hkymstr/Telemetry-monitor/README.md

# Telemetry-monitor
telemetry monitor for raspberry pi pico
