hkymstr/Telemetry-monitor/CAN ADC/simulations/thermocouple_buffer.asc

R1: res; 169
R2: res; 10k
R3: res; 100
U1: OP07
V1: voltage; -5
V2: voltage; PULSE(0 50mV 0.1 10 .1 .1 20 1)
V3: voltage; 5
Named nets: 0, Vee, Vdd
Processor: ATMEL MEGA32U4-MU
$5 each
K type thermocouple
Output voltage: 0 (0C) to 50mV (1200C)
 
50mV to 3V => 60 gain
Gain = 60
A = 1 + R2/R1 = 1 +10k/169 => 60.2
.tran 20
