hkymstr/Telemetry-monitor/CAN ADC/simulations/power_regulator.asc

C1: cap; 2.2µF
C2: cap; 0.1µF
C3: cap; 12µF
C4: cap; 1µF
C5: cap; 4.7µF
C6: cap; 1µF
C7: cap; 22µF
C8: cap; 220pF
D1: diode; 1N4148
D2: schottky; 1N5818
D3: schottky; 1N5818
I1: current; PULSE(0 .1 .01 .00001 .00001 .02)
I2: current; PULSE(0 -.1 .01 .00001 .00001 .02)
L1: ind; 22µH
L2: ind; 10µH
L3: ind; 10µH
R1: res; 1k
R2: res; 1k
R3: res; 10k
R4: res; 10k
R5: res; 30k
R6: res; 1k
R7: res; 29.4k
R8: res; 1k
R9: res; 1k
U1: LT1121-3.3
U2: LT1933
U3: LT1931A
V4: voltage; PULSE(14 8 .01 .00001 .000001 .02 1)
Named nets: 0
.tran 1
R5 = R4*(Vout/1.245-1)
R7 = (|Vout|-1.255)/((1.255/R3)+(8*10^-6))
