hkymstr/Telemetry-monitor/CAN ADC/CAN_adc/CAN_adc.kicad_pcb

## KiCad design CAN ADC/CAN_adc/CAN_adc.kicad_pcb (2024-12-15)

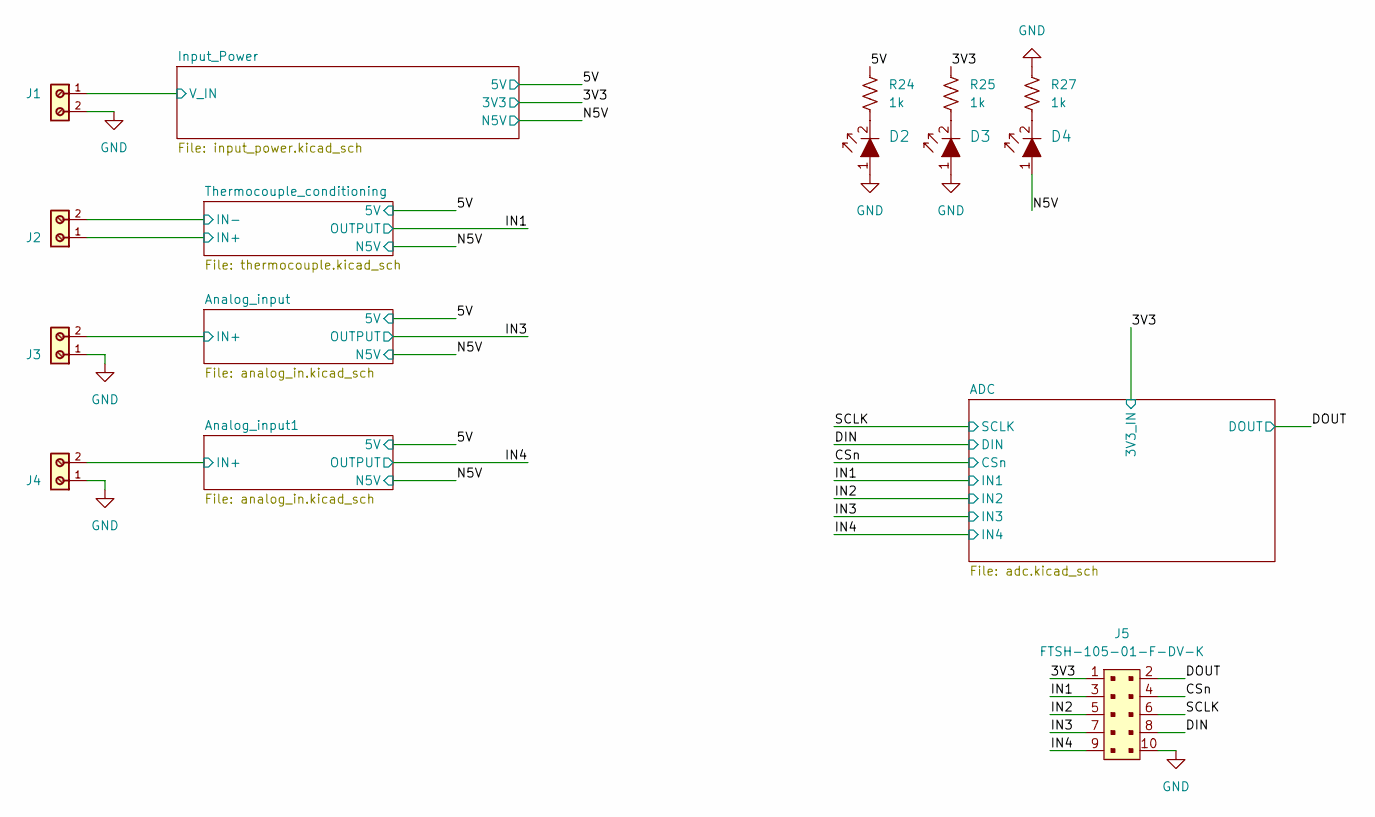
[picture p1: schematic CAN_adc.kicad_sch]

Parts:
D2, D3, D4: LG_L29K-G2J1-24-Z; 0603; MPN LG L29K-G2J1-24-Z; Digi-Key_PN 475-2709-1-ND
J1, J2, J3, J4: 691137710002; PART-NUMBER 691137710002
J5: FTSH-105-01-F-DV-K; PinHeader_2x5_P1.27_SMD; MPN FTSH-105-01-F-DV-K; Digi-Key_PN SAM8796-ND
R24, R25, R27: 1k; R_0603_1608Metric

Connections:
/3V3: J5.1, R25.1; also elsewhere on the board
/5V: R24.1; also elsewhere on the board
/Analog_input1/IN+: J4.2; also elsewhere on the board
/Analog_input/IN+: J3.2; also elsewhere on the board
/CSn: J5.4; also elsewhere on the board
/DIN: J5.8; also elsewhere on the board
/DOUT: J5.2; also elsewhere on the board
/IN1: J5.3; also elsewhere on the board
/IN2: J5.5; also elsewhere on the board
/IN3: J5.7; also elsewhere on the board
/IN4: J5.9; also elsewhere on the board
/Input_Power/V_IN: J1.1; also elsewhere on the board
/N5V: D4.1; also elsewhere on the board
/SCLK: J5.6; also elsewhere on the board
/Thermocouple_conditioning/IN+: J2.1; also elsewhere on the board
/Thermocouple_conditioning/IN-: J2.2; also elsewhere on the board
GND: D2.1, D3.1, J1.2, J3.1, J4.1, J5.10, R27.1; also elsewhere on the board
unnamed: D2.2, R24.2
unnamed: D3.2, R25.2
unnamed: D4.2, R27.2

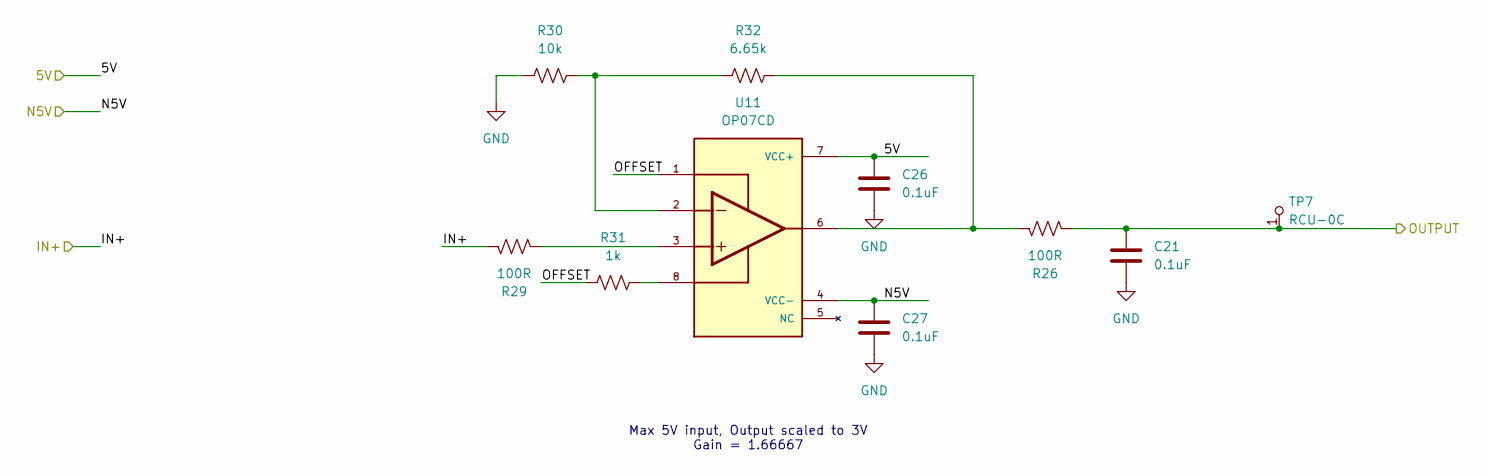
[picture p2: schematic analog_in.kicad_sch]

Parts:
C21, C26, C27: 0.1uF; C_0603_1608Metric_Pad1.08x0.95mm_HandSolder; Part Number CL10B104KB8NNNC
R26, R29: 100R; R_0603_1608Metric; Part Number RC0603FR-07100RL
R30: 10k; R_0603_1608Metric; Part Number RC0603FR-0710KL
R31: 1k; R_0603_1608Metric
R32: 6.65k; R_0603_1608Metric; Part Number RC0603FR-076K65L
TP7: RCU-0C; PROBE_PAD_0603; MPN RCU-0C; Digi-Key_PN A106145CT-ND
U11: OP07CD; SOIC127P599X175-8N

Connections:
/5V: C26.1, U11.7 (VCC+); also elsewhere on the board
/Analog_input/IN+: R29.1; also elsewhere on the board
/Analog_input/OFFSET: R31.1, U11.1
/IN3: C21.1, R26.2, TP7.1; also elsewhere on the board
/N5V: C27.1, U11.4 (VCC-); also elsewhere on the board
GND: C21.2, C26.2, C27.2, R30.1; also elsewhere on the board
unnamed: R26.1, R32.2, U11.6
unnamed: R29.2, U11.3
unnamed: R30.2, R32.1, U11.2
unnamed: R31.2, U11.8

Parts of its further copies:
C16, C17, C18: 0.1uF; C_0603_1608Metric_Pad1.08x0.95mm_HandSolder; Part Number CL10B104KB8NNNC
R19, R23: 100R; R_0603_1608Metric; Part Number RC0603FR-07100RL
R20: 10k; R_0603_1608Metric; Part Number RC0603FR-0710KL
R21: 1k; R_0603_1608Metric
R22: 6.65k; R_0603_1608Metric; Part Number RC0603FR-076K65L
TP6: RCU-0C; PROBE_PAD_0603; MPN RCU-0C; Digi-Key_PN A106145CT-ND
U7: OP07CD; SOIC127P599X175-8N

Connections of its further copies:
/5V: C16.1, U7.7 (VCC+); also elsewhere on the board
/Analog_input1/IN+: R19.1; also elsewhere on the board
/Analog_input1/OFFSET: R21.1, U7.1
/IN4: C18.1, R23.2, TP6.1; also elsewhere on the board
/N5V: C17.1, U7.4 (VCC-); also elsewhere on the board
GND: C16.2, C17.2, C18.2, R20.1; also elsewhere on the board
unnamed: R19.2, U7.3
unnamed: R20.2, R22.1, U7.2
unnamed: R21.2, U7.8
unnamed: R22.2, R23.1, U7.6

Notes on the sheet:
Max 5V input, Output scaled to 3V Gain = 1.66667

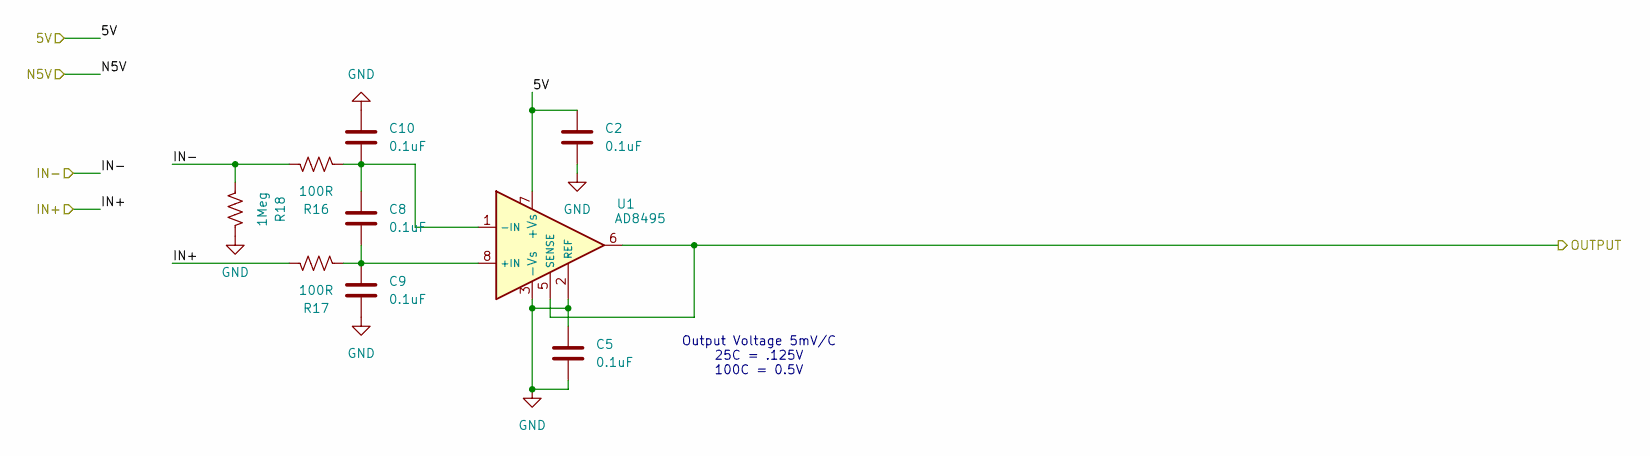
[picture p3: schematic thermocouple.kicad_sch]

Parts:
C2, C5, C8, C9, C10: 0.1uF; C_0603_1608Metric_Pad1.08x0.95mm_HandSolder; Part Number CL10B104KB8NNNC
R16, R17: 100R; R_0603_1608Metric; Part Number RC0603FR-07100RL
R18: 1Meg; R_0603_1608Metric; Part Number RC0603FR-071ML
U1: AD8495; MSOP-8_3x3mm_P0.65mm

Connections:
/5V: C2.1, U1.7 (+Vs); also elsewhere on the board
/IN1: U1.5 (SENSE), U1.6; also elsewhere on the board
/Thermocouple_conditioning/IN+: R17.1; also elsewhere on the board
/Thermocouple_conditioning/IN-: R16.1, R18.2; also elsewhere on the board
GND: C2.2, C5.1, C5.2, C9.2, C10.1, R18.1, U1.2 (REF), U1.3 (-Vs); also elsewhere on the board
unnamed: C8.2, C9.1, R17.2, U1.8 (+IN)
unnamed: C8.1, C10.2, R16.2, U1.1 (-IN)

Notes on the sheet:
Output Voltage 5mV/C 25C = .125V 100C = 0.5V

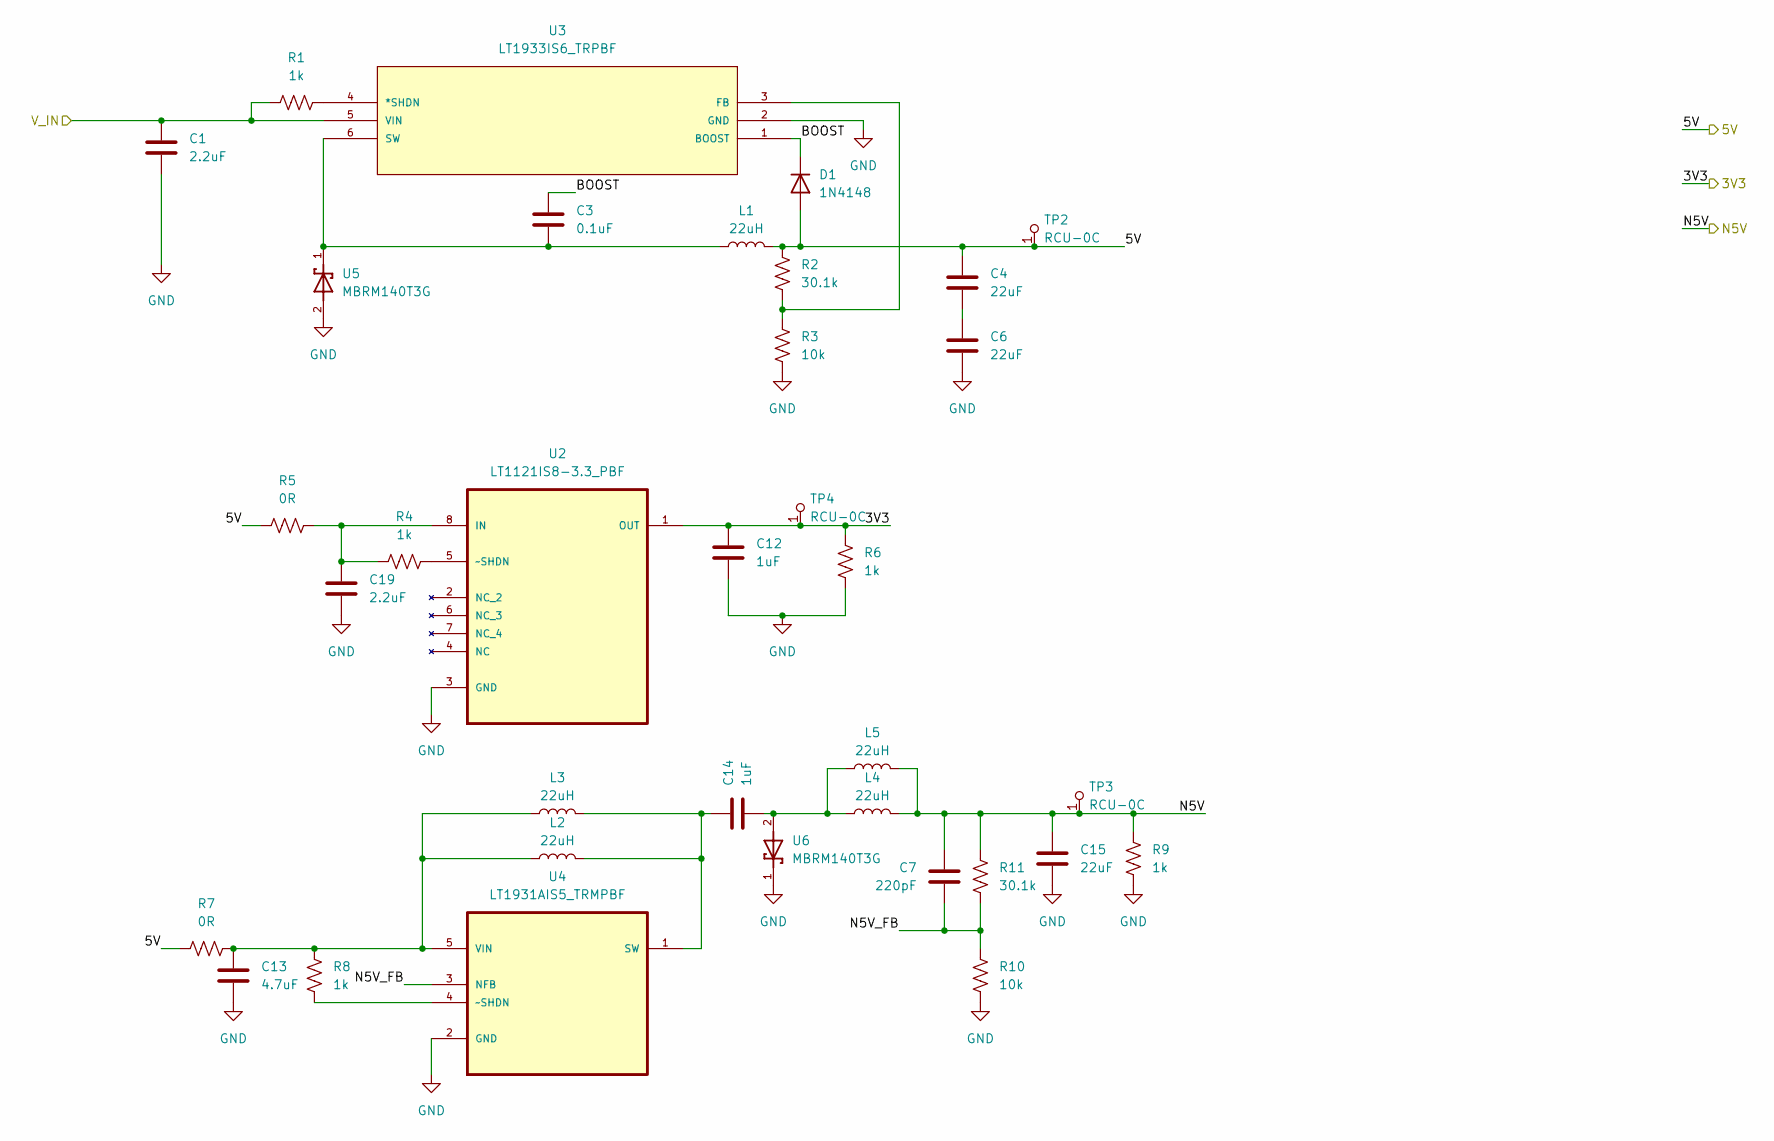
[picture p4: schematic input_power.kicad_sch]

Parts:
C1, C19: 2.2uF; C_1206_3216Metric; Part Number CL31B225KBHNNNE
C3: 0.1uF; C_0603_1608Metric_Pad1.08x0.95mm_HandSolder; Part Number CL10B104KB8NNNC
C4, C6, C15: 22uF; C_0805_2012Metric_Pad1.18x1.45mm_HandSolder; Part Number CL21A226MAYNNNE
C7: 220pF; C_0603_1608Metric_Pad1.08x0.95mm_HandSolder; Part Number 0603B221K500CT
C12, C14: 1uF; C_0603_1608Metric_Pad1.08x0.95mm_HandSolder; Part Number CL10B105KA8NNNC
C13: 4.7uF; C_1206_3216Metric_Pad1.33x1.80mm_HandSolder; Part Number CL31B475KBHNFNE
D1: 1N4148; D_SOD-523; Part Number 1N4148WT
L1, L2, L3, L4, L5: 22uH; L_1210_3225Metric_Pad1.42x2.65mm_HandSolder; Part Number CBC3225T220KR
R1, R4, R6, R8, R9: 1k; R_0603_1608Metric
R2, R11: 30.1k; R_0603_1608Metric; Part Number RMCF0603FT30K1
R3, R10: 10k; R_0603_1608Metric; Part Number RC0603FR-0710KL
R5, R7: 0R; R_0603_1608Metric
TP2, TP3, TP4: RCU-0C; PROBE_PAD_0603; MPN RCU-0C; Digi-Key_PN A106145CT-ND
U2: LT1121IS8-3.3_PBF; SOIC127P600X175-8N; MPN LT1121IS8#PBF
U3: LT1933IS6_TRPBF; TSOT-23_S6; MANUFACTURER_PART_NUMBER lt1933is6
U4: LT1931AIS5_TRMPBF; SOT95P280X100-5N; MPN LT1931ES5#PBF
U5, U6: MBRM140T3G; DIO_MBRM110LT1G

Connections:
/3V3: C12.1, R6.1, TP4.1, U2.1 (OUT); also elsewhere on the board
/5V: C4.1, D1.2 (A), L1.2, R2.1, R5.1, R7.1, TP2.1; also elsewhere on the board
/Input_Power/BOOST: C3.1, D1.1 (K), U3.1 (BOOST)
/Input_Power/N5V_FB: C7.2, R10.1, R11.2, U4.3 (NFB)
/Input_Power/V_IN: C1.1, R1.2, U3.5 (VIN); also elsewhere on the board
/N5V: C7.1, C15.1, L4.2, L5.2, R9.1, R11.1, TP3.1; also elsewhere on the board
GND: C1.2, C6.2, C12.2, C13.2, C15.2, C19.2, R3.2, R6.2, R9.2, R10.2, U2.3 (GND), U3.2 (GND), U4.2 (GND), U5.2, U6.1; also elsewhere on the board
unnamed: C4.2, C6.1
unnamed: C14.2, L4.1, L5.1, U6.2
unnamed: C19.1, R4.2, R5.2, U2.8 (IN)
unnamed: R4.1, U2.5 (~SHDN)
unnamed: R1.1, U3.4 (*SHDN)
unnamed: R2.2, R3.1, U3.3 (FB)
unnamed: C3.2, L1.1, U3.6 (SW), U5.1
unnamed: C14.1, L2.2, L3.2, U4.1 (SW)
unnamed: C13.1, L2.1, L3.1, R7.2, R8.1, U4.5 (VIN)
unnamed: R8.2, U4.4 (~SHDN)

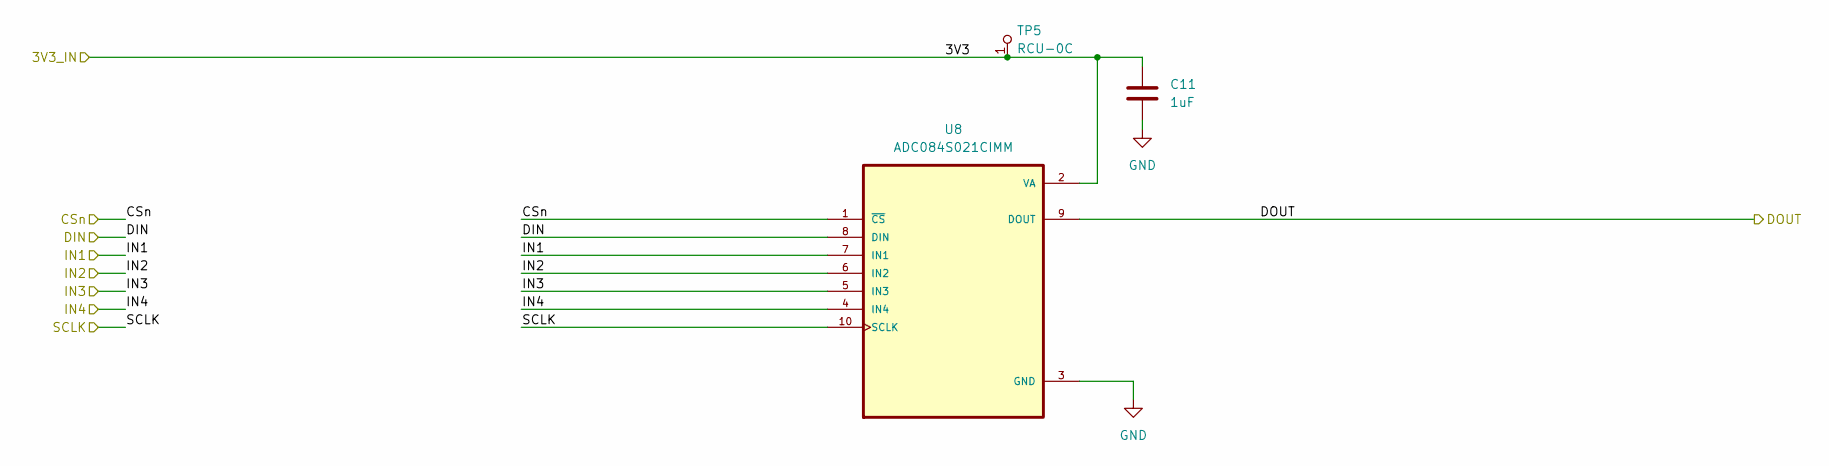
[picture p5: schematic adc.kicad_sch]

Parts:
C11: 1uF; C_0603_1608Metric_Pad1.08x0.95mm_HandSolder; Part Number CL10B105KA8NNNC
TP5: RCU-0C; PROBE_PAD_0603; MPN RCU-0C; Digi-Key_PN A106145CT-ND
U8: ADC084S021CIMM; SOP50P490X110-10N

Connections:
/3V3: C11.1, TP5.1, U8.2 (VA); also elsewhere on the board
/CSn: U8.1 (~CS); also elsewhere on the board
/DIN: U8.8 (DIN); also elsewhere on the board
/DOUT: U8.9 (DOUT); also elsewhere on the board
/IN1: U8.7 (IN1); also elsewhere on the board
/IN2: U8.6 (IN2); also elsewhere on the board
/IN3: U8.5 (IN3); also elsewhere on the board
/IN4: U8.4 (IN4); also elsewhere on the board
/SCLK: U8.10 (SCLK); also elsewhere on the board
GND: C11.2, U8.3 (GND); also elsewhere on the board

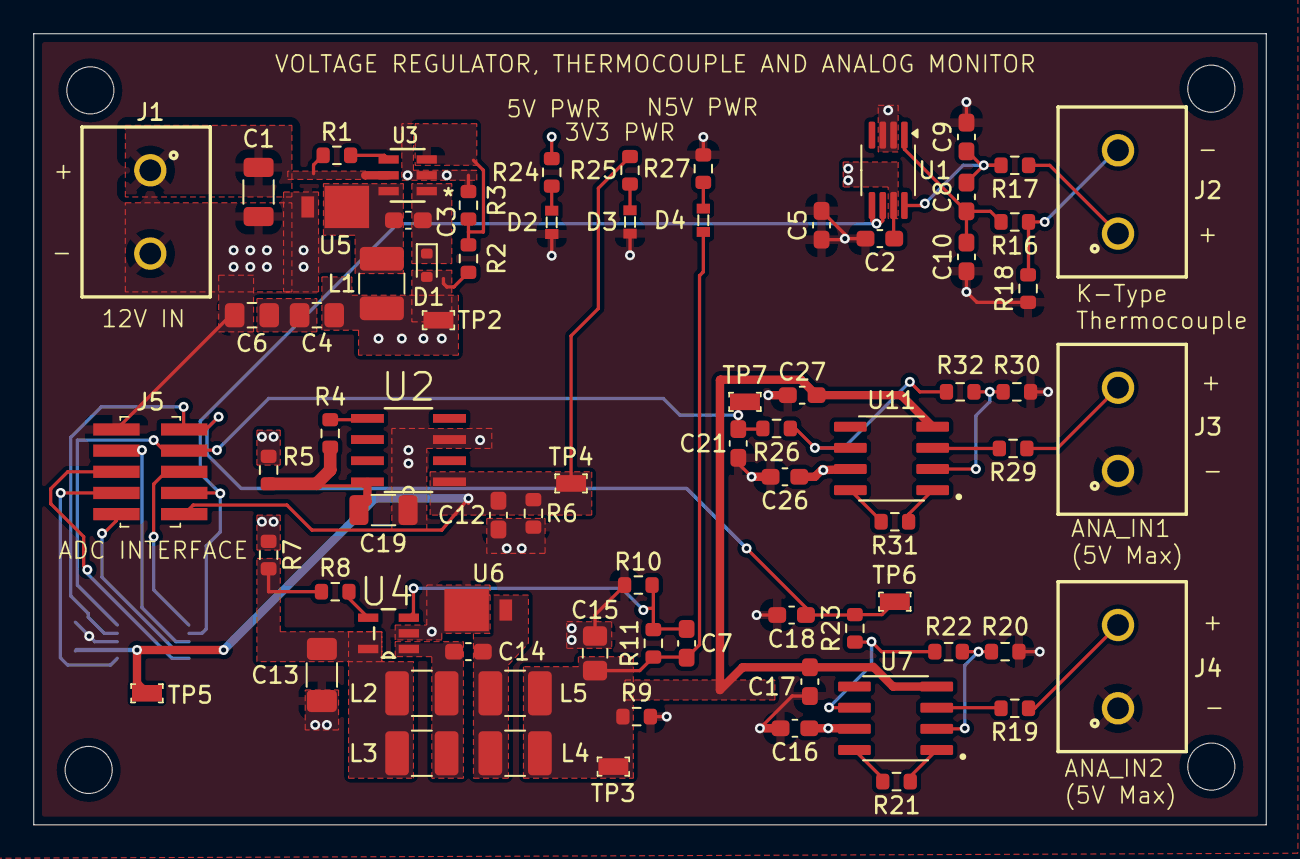
[picture p6: board CAN_adc.kicad_pcb from above]

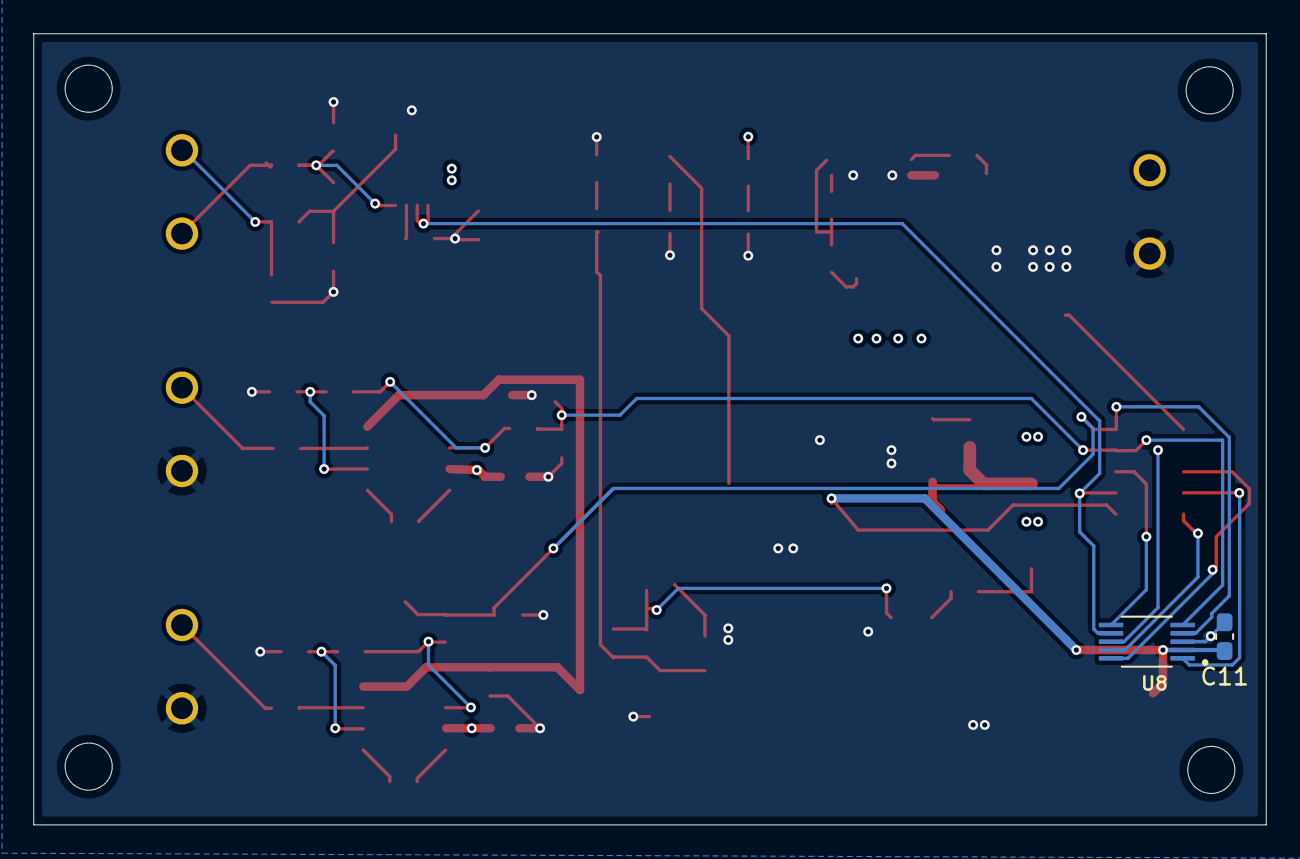
[picture p7: board CAN_adc.kicad_pcb from below]

Board: 4 copper layers, 74.0 x 47.5 mm, 78 parts (2 on the bottom side), 44 nets.
