hkymstr/Telemetry-monitor/(threads)

Thread 1 (2024-12-15):

Incorrect footprint for Diode D1

hkymstr, 2024-12-15:
The BOM and PWB footprint has a different footprint.  Update layout for BOM to fix this issue.

Thread 2 (2024-12-15):

Ouptut voltage is high (5.25V)

hkymstr, 2024-12-15:
The output voltage of the 5V converter is a bit high, requires trimming to be 5V.  Currently output is at 5.25V

Thread 5 (2024-12-27):

Code keeps reading out duplicate channels

hkymstr, 2024-12-27:
This is a pipelined ADC. So the channel that is read out is the previously selected channel.  The code needs to be revised to accomodate.

hkymstr, 2024-12-27:
this was fixes in the latest code: [code_rp2040_external_internal_ADC.py](https://github.com/hkymstr/Telemetry-monitor/blob/main/code_rp2040_external_internal_ADC.py)

Closed 2024-12-27.
