hkymstr/Telemetry-monitor/(commit log)

2024-12-15 Add files via upload
    file to read ADC via SPI
2024-12-15 Add files via upload
    KiCAD files
    [CAN_adc-B_Cu.gbr, CAN_adc-B_Mask.gbr, CAN_adc-B_Paste.gbr, CAN_adc-B_Silkscreen.gbr, CAN_adc-Edge_Cuts.gbr, CAN_adc-F_Cu.gbr, CAN_adc-F_Mask.gbr, CAN_adc-F_Paste.gbr]
2024-12-25 Update code.py
    Updated code to correctly address ADC. Not getting correct ADC channels reads back
    [code.py]
2024-12-25 Update code.py
    revised code, still not get consistent channel 2 and 3 reads, they seem to switch
2024-12-27 Create telem_arduino_uno_r3
    Code revision for Arduino Uno R3 with CAN board to log data on SDcard.
2024-12-27 Create code_rp2040_external_internal_ADC.py
    code for an RP2040 pico to read external ADC (8-bit) and internal ADC (12-bit) plus temperature monitoring
2024-12-27 Update telem_arduino_uno_r3
    updated ADC channels for external ADC
2024-12-27 Update telem_arduino_uno_r3
    Edited code for Arduino to account for pipelined ADC reads. The current channel selected is the previous channel readout.
2024-12-27 Update code_rp2040_external_internal_ADC.py
    revised code for pipelined ADC reads
2024-12-27 Update code_rp2040_external_internal_ADC.py
    this code fixes the pipelining of the ADCs.
    [code_rp2040_external_internal_ADC.py]
2024-12-27 Update rp2040_adc084s021
    fixed pipelining and added voltage conversion
2024-12-29 Update code_rp2040_external_internal_ADC.py
    Revised this code to read external ADC in pipelined fashion. Also maintain internal ADC measurements and conversions.
